zhengnianli/stm32_weather/src/dht11/dht11.h

#ifndef _dht11_H
#define _dht11_H

#include "config.h"

#define DHT11 (GPIO_Pin_11) //PG11
#define GPIO_DHT11 GPIOG

#define DHT11_DQ_IN PGin(11)	    //输入
#define DHT11_DQ_OUT PGout(11)  	//输出

void DHT11_IO_OUT(void);
void DHT11_IO_IN(void);
u8 DHT11_Init(void);
void DHT11_Rst(void);
u8 DHT11_Check(void);
u8 DHT11_Read_Bit(void);
u8 DHT11_Read_Byte(void);
u8 DHT11_Read_Data(u8 *temp,u8 *humi);

#endif
