zhengnianli/stm32_weather/src/LD3320_Driver/Reg_RW.c

#include "Reg_RW.h"

/***********************************************************
* 名    称：static uint8 spi_send_byte(uint8 byte)
* 功    能： 写SPI3
* 入口参数：  
* 出口参数：
* 说    明：
* 调用方法： 
**********************************************************/ 
static uint8 spi_send_byte(uint8 byte)
{
	/* 循环检测发送缓冲区是否是空 */
	while (SPI_I2S_GetFlagStatus(SPI3, SPI_I2S_FLAG_TXE) == RESET);

	/*通过SPI3外设发出数据*/
	SPI_I2S_SendData(SPI3,byte);

	/* 等待接收数据，循环检查接收数据缓冲区 */
	while (SPI_I2S_GetFlagStatus(SPI3,SPI_I2S_FLAG_RXNE) == RESET);

	/* 返回读出的数据 */
	return SPI_I2S_ReceiveData(SPI3);
}
/***********************************************************
* 名    称：void LD_WriteReg(uint8 data1,uint8 data2)
* 功    能： 写ld3320寄存器
* 入口参数：  
* 出口参数：
* 说    明：
* 调用方法： 
**********************************************************/ 
void LD_WriteReg(uint8 data1,uint8 data2)
{
	LD_CS_L();

	LD_SPIS_L();	//WR 低电平有效

	spi_send_byte(0x04);

	spi_send_byte(data1);

	spi_send_byte(data2);

	LD_CS_H();

}
/***********************************************************
* 名    称：uint8 LD_ReadReg(uint8 reg_add)
* 功    能：读ld3320寄存器
* 入口参数：  
* 出口参数：
* 说    明：
* 调用方法： 
**********************************************************/ 
uint8 LD_ReadReg(uint8 reg_add)
{
	uint8 i;

	LD_CS_L();

	LD_SPIS_L();

	spi_send_byte(0x05);

	spi_send_byte(reg_add);

	i=spi_send_byte(0x00);	/*读SPI*/

	LD_CS_H();

	return(i);
}
