zhengnianli/stm32_weather/src/sd/spi.h

#ifndef _spi_H
#define _spi_H

#include "system.h"

void SPI1_Init(void);			 //初始化SPI1口
void SPI1_SetSpeed(u8 SpeedSet); //设置SPI1速度   
u8 SPI1_ReadWriteByte(u8 TxData);//SPI1总线读写一个字节

void SPI2_Init(void);			 //初始化SPI2口
void SPI2_SetSpeed(u8 SpeedSet); //设置SPI2速度   
u8 SPI2_ReadWriteByte(u8 TxData);//SPI2总线读写一个字节

#endif
