zhengnianli/stm32_weather/(notices)

Notices in the files:
src/radio/fm_radio.c:
Copyright (C), 2010-2011, °²¸»À³µç×Ó www.armfly.com
